kirill271204/Bipolar-Pulse-Power-Supply-Unit-for-Electrochemical-Machining-ECM-/LTSpice Circuits/Capacitive_Load.asc

C1: cap; 56µ; Rser=11.5m Lser=13.4n mfg="Würth Elektronik" pn="890764429002CS WCAP-FTDB 52.5x57x43.5x29.5x4" type="Box"
C2: cap; 56µ; Rser=11.5m Lser=13.4n mfg="Würth Elektronik" pn="890764429002CS WCAP-FTDB 52.5x57x43.5x29.5x4" type="Box"
C3: cap; 560µ; Rser=11.5m Lser=13.4n mfg="Würth Elektronik" pn="890764429002CS WCAP-FTDB 52.5x57x43.5x29.5x4" type="Box"
D2: diode; VS-E5PH6012
L1: ind; 27µ; Ipk=49 Rser=2.8m Rpar=1.413K Cpar=0 mfg="Coilcraft" pn="AGP4233-153"
R1: Res; 7.5
R2: res; 10
R3: res; 10
R4: res; 10
R5: res; 10
R6: res; 10
R7: res; 10
R8: res; 10
R9: res; 10
R10: res; 10
S1: sw; S_B
S2: sw; S_N1
S3: sw; S_P3
S4: sw; S_P1
S5: sw; S_N2
S6: sw; S_C1
S7: sw; S_C2
S8: sw; S_P2
S9: sw; S_N3
V1: voltage; PULSE(0 1 0 1n 1n 124.996u 150u)
V2: voltage; PULSE(0 1 100u 1n 1n 4.996u 150u)
V3: voltage; PULSE(0 1 0 1n 1n 9.996u 150u)
V4: voltage; PULSE(0 1 0 1n 1n 9.996u 150u)
V5: voltage; PULSE(0 1 0 1n 1n 9.996u 150u)
V6: voltage; PULSE(0 1 100u 1n 1n 4.996u 150u)
V7: voltage; PULSE(0 1 100u 1n 1n 4.996u 150u)
V8: voltage; PULSE(0 1 125u 1n 1n 24.996u 150u)
V9: voltage; PULSE(0 1 125u 1n 1n 24.996u 150u)
V_in: voltage; 12.5
Named nets: 0, Gate_S_B, Gate_S_N1, Gate_S_P1, Gate_S_P2, Gate_S_P3, Gate_S_N2, Gate_S_N3, Gate_S_C1, Gate_S_C2
.model S_B SW(Ron=1 Roff=1Meg Vt=.5)
.model S_P1 SW(Ron=1 Roff=1Meg Vt=.5)
.model S_N1 SW(Ron=1 Roff=1Meg Vt=.5)
.model S_C1 SW(Ron=1 Roff=1Meg Vt=.5)
.model S_P2 SW(Ron=1 Roff=1Meg Vt=.5)
.model S_N2 SW(Ron=1 Roff=1Meg Vt=.5)
.model S_C2 SW(Ron=1 Roff=1Meg Vt=.5)
.model S_P3 SW(Ron=1 Roff=1Meg Vt=.5)
.model S_N3 SW(Ron=1 Roff=1Meg Vt=.5)
.tran 0 5m
