kirill271204/Bipolar-Pulse-Power-Supply-Unit-for-Electrochemical-Machining-ECM-/(commit log)

2026-05-03 Create Resistive Load
2026-05-03 Create Voltage Droop
